TechsPassion/TechsPassion_Lite_Robot/(commit log)

2026-09-25 Initial release of the TechsPassion Lite Robot firmware
    ESP32-S3 camera robot with web control, radar scan, auto pilot,
    hotspot fallback and OTA updates.
2026-09-25 Point pin comment at the README instead of a missing doc
    [TechsPassion_Lite_Robot.ino]
2026-09-26 Add original wiring diagram to README
2026-09-26 Add ESP32-S3-CAM and motor driver pinout images
2026-10-05 Add Pad Starter example for the app's Controller mode
    A simple ESP32 sketch that drives a robot from the TechsPassion app's
    joystick and buttons (GET /pad?x=&y=&b=), with an automatic stop if the
    phone goes quiet. The README explains the protocol.
